Ajilaca/peruri-chipathon-2026/formal/phase08-keccak-stream/README.md

# formal/phase08-keccak-stream/

- Folder ini: sponge dua ronde (`keccak_sponge_r2_*`), Phase 8a.
- `8b/`: sampler `cbd2_core` dan `sample_ntt_core`, lebar keluaran W1 dan W2 (`*_w2.sby`).
- `8c/`: sequencer dengan sampler, varian STORE dan STREAM; `keccak_sampler_stub.sv` menggantikan sampler.
- `8d/`: varian OVERLAP.

Hasil: [../../evidence/phase08/](../../evidence/phase08/README.md).
