Ajilaca/peruri-chipathon-2026/docs/README.md

# docs/

Dokumentasi proyek. Kode ada di `rtl/`, bukti mentah di [`../evidence/`](../evidence/README.md).

| Item | Isi |
|---|---|
| [ROADMAP.md](ROADMAP.md) | fase, kriteria selesai, matriks ablasi (satu baris per konfigurasi, angka dari bukti) |
| [decisions/](decisions/README.md) | ADR, ringkasan keputusan aktif, daftar pilihan terbuka |
| [results/](results/README.md) | satu file hasil per fase (`phaseNN.md`), dasar persetujuan fase |
| [evidence/](evidence/README.md) | indeks bukti per fase (isinya ada di `../evidence/`) |
| [reports/](reports/README.md) | laporan PDF per fase dan laporan lengkap |

Urutan baca : README root, ROADMAP, `decisions/decision_summary.md`, `results/phase9m.md`.
