Ajilaca/peruri-chipathon-2026/evidence/phase09/9c/regression_phase8.md

# Regresi Fase 8 pada Fase 9 (CRG-5), 2026-10-04

MEASURED: skrip verifikasi Fase 8 dijalankan ulang pada working tree yang memuat Fase 9 (file Fase 6-8 yang dibekukan tidak diubah; lihat `verify.md`), `scripts/test/phase8cd_verify.sh` lalu `KS_OUTW=2 scripts/test/phase8b_verify.sh` (yang menjalankan ulang `scripts/test/phase8a_verify.sh`). Hanya header bagian dan baris hasil dari log mentah yang disimpan di sini (log mentah sekitar 1 MB; alur lengkap `scripts/phase8*_verify.sh`). Hanya simulasi, lint, dan formal.

## scripts/test/phase8cd_verify.sh
```
## V2 golden model (STORE, STREAM, OVERLAP, STRESS) against the unmodified golden K-PKE, hazard checker
rc=0
## V2 ROM regenerated byte for byte
rc=0
## V1 verilator --lint-only -Wall kpke_smp_top_s10 (VAR=0 STREAM_A=0 OVERLAP=0 NPOLY=24)
rc=0
## V1 slang kpke_smp_top_s10 (VAR=0 STREAM_A=0 OVERLAP=0 NPOLY=24)
rc=0
## V1 verilator --lint-only -Wall kpke_smp_top_s10 (VAR=1 STREAM_A=1 OVERLAP=0 NPOLY=12)
rc=0
## V1 slang kpke_smp_top_s10 (VAR=1 STREAM_A=1 OVERLAP=0 NPOLY=12)
rc=0
## V1 verilator --lint-only -Wall kpke_smp_top_s10 (VAR=2 STREAM_A=1 OVERLAP=1 NPOLY=12)
rc=0
## V1 slang kpke_smp_top_s10 (VAR=2 STREAM_A=1 OVERLAP=1 NPOLY=12)
rc=0
## V1 verilator --lint-only -Wall kpke_smp_top_s10 (VAR=3 STREAM_A=1 OVERLAP=1 NPOLY=12)
rc=0
## V1 slang kpke_smp_top_s10 (VAR=3 STREAM_A=1 OVERLAP=1 NPOLY=12)
rc=0
## V3-V6 verilator VAR=0
[verilator] TOTAL: 6/6 passed
rc=0
## V3-V6 icarus VAR=0
[icarus] TOTAL: 6/6 passed
rc=0
## V3-V6 verilator VAR=1
[verilator] TOTAL: 8/8 passed
rc=0
## V3-V6 icarus VAR=1
[icarus] TOTAL: 8/8 passed
rc=0
## V3-V6 verilator VAR=2
[verilator] TOTAL: 9/9 passed
rc=0
## V3-V6 icarus VAR=2
[icarus] TOTAL: 9/9 passed
rc=0
## V3-V6 verilator VAR=3
[verilator] TOTAL: 9/9 passed
rc=0
## V3-V6 icarus VAR=3
[icarus] TOTAL: 9/9 passed
rc=0
## V7 formal 8c: formal/run/run_formal_phase8c.py
rc=0
## V7 formal 8d: formal/run/run_formal_phase8d.py
rc=0
## V8 Phase 6 files unmodified since their commit (git diff against the Phase 7 base 6874609)
OVERALL: PASS
```

## KS_OUTW=2 scripts/test/phase8b_verify.sh
```
## V10 regression: scripts/test/phase8a_verify.sh (K0 and C5)
[verilator] TOTAL: 9/9 passed
[icarus] TOTAL: 9/9 passed
OVERALL: PASS
[verilator] TOTAL: 9/9 passed
[icarus] TOTAL: 9/9 passed
OVERALL: PASS
rc=0
## V10 regression: formal/run/run_formal_phase7.py
rc=0
## V10 regression: formal/run/run_formal_phase8a.py
rc=0
## V1 verilator --lint-only -Wall sample_ntt_core (OUTW = 2)
rc=0
## V1 verilator --lint-only -Wall cbd2_core (OUTW = 2)
rc=0
## V1 verilator --lint-only -Wall keccak_sampler (CORE_R2 = 1, OUTW = 2)
rc=0
## V1 verilator --lint-only -Wall keccak_sampler (CORE_R2 = 0, OUTW = 2)
rc=0
## V1 slang keccak_sampler (OUTW = 2)
rc=0
## V2 golden sampler model against the unmodified golden primitives
rc=0
## V3-V8 verilator (OUTW = 2)
[verilator] TOTAL: 34/34 passed
rc=0
## V3-V8 icarus (OUTW = 2)
[icarus] TOTAL: 34/34 passed
rc=0
## V10 rerun of the W1 test set against the current RTL (OUTW = 1) verilator
[verilator] TOTAL: 31/31 passed
rc=0
## V10 rerun of the W1 test set against the current RTL (OUTW = 1) icarus
[icarus] TOTAL: 31/31 passed
rc=0
## V9 formal: formal/run/run_formal_phase8b.py (W1 and W2 rows)
rc=0
OVERALL: PASS
```

## Parameter terkunci (check_params.py)
```
ok        Q         = 3329
ok        N         = 256
ok        ZETA      = 17
ok        K         = 3
ok        ETA1      = 2
ok        ETA2      = 2
ok        DU        = 10
ok        DV        = 4
ok        EK_BYTES  = 1184
ok        DK_BYTES  = 2400
ok        CT_BYTES  = 1088
ok        SS_BYTES  = 32

check_params: all locked parameters match.
```
