Ajilaca/peruri-chipathon-2026/evidence/phase08/8b/quartus_SM1-K0.md

# MEASURED - Hasil Quartus untuk revisi `SM1-K0`

- Dibuat: 2026-10-03 08:03 UTC oleh `extract_quartus_report.py` (nilai disalin dari laporan, tidak dihitung)
- Direktori sumber: `quartus/phase08b_sampler/output_files_SM1-K0`
- Catatan: Fase 8b tahap W1: keccak_sampler (SampleNTT dan CBD2 streaming, satu koefisien per siklus), revisi SM1-K0, kernel-only dengan virtual pin; RTL rtl/sample pada working tree di atas commit dcae678 (di-commit sesudahnya)

## Fitter (`SM1-K0.fit.summary`)

| Item | Nilai (verbatim) |
|---|---|
| Fitter Status | Successful - Sat Oct  3 15:01:58 2026 |
| Quartus Prime Version | 25.1std.0 Build 1129 10/21/2025 SC Lite Edition |
| Revision Name | SM1-K0 |
| Top-level Entity Name | keccak_sampler |
| Family | Cyclone V |
| Device | 5CSEBA6U23I7 |
| Timing Models | Final |
| Logic utilization (in ALMs) | 3,470 / 41,910 ( 8 % ) |
| Total registers | 1914 |
| Total pins | 0 / 314 ( 0 % ) |
| Total block memory bits | 0 / 5,662,720 ( 0 % ) |
| Total RAM Blocks | 0 / 553 ( 0 % ) |
| Total DSP Blocks | 0 / 112 ( 0 % ) |
| Total PLLs | 0 / 6 ( 0 % ) |
| Total DLLs | 0 / 4 ( 0 % ) |

Penyebut di atas adalah penyebut fitter sendiri; kutip persis seperti tercetak.

## Timing (`SM1-K0.sta.summary`)

| Tipe | Slack (ns) | TNS |
|---|---|---|
| Slow 1100mV 100C Model Setup 'clk_i' | 23.928 | 0.000 |
| Slow 1100mV 100C Model Hold 'clk_i' | 0.414 | 0.000 |
| Slow 1100mV 100C Model Minimum Pulse Width 'clk_i' | 19.243 | 0.000 |
| Slow 1100mV -40C Model Setup 'clk_i' | 24.496 | 0.000 |
| Slow 1100mV -40C Model Hold 'clk_i' | 0.438 | 0.000 |
| Slow 1100mV -40C Model Minimum Pulse Width 'clk_i' | 19.136 | 0.000 |
| Fast 1100mV 100C Model Setup 'clk_i' | 30.287 | 0.000 |
| Fast 1100mV 100C Model Hold 'clk_i' | 0.176 | 0.000 |
| Fast 1100mV 100C Model Minimum Pulse Width 'clk_i' | 19.562 | 0.000 |
| Fast 1100mV -40C Model Setup 'clk_i' | 32.052 | 0.000 |
| Fast 1100mV -40C Model Hold 'clk_i' | 0.162 | 0.000 |
| Fast 1100mV -40C Model Minimum Pulse Width 'clk_i' | 19.553 | 0.000 |

- Slack setup terburuk: **23.928 ns** (Slow 1100mV 100C Model Setup 'clk_i')
- Slack hold terburuk: **0.162 ns** (Fast 1100mV -40C Model Hold 'clk_i')

## Fmax (`SM1-K0.sta.rpt`, panel Fmax Summary)

| Model | Fmax | Fmax terbatas | Nama clock | Catatan |
|---|---|---|---|---|
| Slow 1100mV 100C Model Fmax Summary | 62.22 MHz | 62.22 MHz | clk_i |  |
| Slow 1100mV -40C Model Fmax Summary | 64.5 MHz | 64.5 MHz | clk_i |  |

## Jumlah pesan log kompilasi

- Peringatan kritis: 1
- Peringatan: 7
- Kesalahan: 0

Peringatan kritis harus dibahas secara tertulis.
