Ajilaca/peruri-chipathon-2026/docs/results/README.md

# Artefak hasil per fase

Satu file per fase yang selesai: `phase<NN>.md` (NN mengikuti `docs/ROADMAP.md`; `phase05m` dan `phase9m` untuk sub-fase).
Ini satu halaman yang dibaca peninjau untuk memutuskan "apakah fase ini benar-benar selesai?".

- Hanya fakta, dari file di repository ini. `PASS` memerlukan bukti yang ada.
- Semua baris kriteria harus punya bukti yang ada sebelum meminta persetujuan.
- Fase yang jujur berstatus `PARTIAL` boleh; `DONE` dengan bukti yang hilang tidak boleh.
