Ajilaca/peruri-chipathon-2026/evidence/phase05m/test_plan_s7.md

<!-- claim-lint: skip-file (internal test plan, not proposal text) -->
# Fase 5M, langkah S7: pecah jalur baca memori (P = 6 -> 7) - test plan dan aturan adopsi

Ditulis 2026-10-02, sebelum RTL S7 apa pun dan sebelum pengukuran S7 apa pun (CRG-4). Lingkup dan aturan: ADR 0017, ADR 0019 (catatan amandemen 2: S7 dan S8
direncanakan sebelum Fase 7), ADR 0020 (M6 adalah basis). Konfigurasi basis: M6 (`rtl/ntt/ntt_core_m6_p6.sv`: Barrett, INTT tanpa pass skala,
P = 6, NTT = INTT = 119 siklus; median Fmax MEASURED seed 1-6 34.430 MHz, ALM 9,394-9,441, 16 DSP,
`evidence/phase05m/s6/selection_worksheet.md`). Label: MEASURED, INFERENCE, ESTIMATE, NOT MEASURED.

## 1. Perubahannya (satu perubahan)
Jalur kritis C4b-B / M6 dimulai di stage baca `rtl/mem/poly_mem_multiport_pipe.sv`: register kendali (bank, offset, slot, setelah potongan M) ->
pemilih alamat baca per bank di antara 16 port -> baca penyimpanan (32 word per bank, flip-flop) -> pemilih keluaran (bank, sub-port) di antara 16 port baca ->
`sub_mod` -> pengali. MEASURED (baseline C3-P6, memori yang sama): dekode alamat baca dan mux baca 21.292 ns dari 29.345 ns
(`evidence/phase05/baseline/c3p6_critical_path.md`); untuk C4b-B 21.03 ns + `sub_mod` 4.22 ns + DSP 3.59 ns
(`evidence/phase05/5c/precheck_critical_path.md`). S7 menaruh satu stage register di tengah bacaan itu:
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
