Ajilaca/peruri-chipathon-2026/evidence/phase05m/test_plan_s8.md

<!-- claim-lint: skip-file (internal test plan, not proposal text) -->
# Fase 5M, langkah S8: register jalur tulis dan satu gelembung per arah (P = 7 -> 8) - test plan dan aturan adopsi

Ditulis 2026-10-02, setelah RTL S8 ditulis dan di-lint (Verilator `-Wall`, slang: 0 peringatan) tetapi sebelum simulasi S8 apa pun dan sebelum kompilasi Quartus
S8 apa pun (CRG-4: tidak ada di bawah yang bergantung pada pengukuran S8). Lingkup dan aturan: ADR 0017 (S8 = tuas 4 paket keputusan: P -> 8, satu stall tak bergantung data
per transformasi), ADR 0019 (catatan amandemen 2: S7 dan S8 direncanakan sebelum Fase 7), ADR 0020, Amandemen A1 `test_plan.md` (regresi penuh Fase 0-5 dijalankan
sekali, di S8, pada pohon akhir). Konfigurasi basis: S7 (`rtl/ntt/ntt_core_s7_p7.sv`, revisi S7, seed 1-6 di `s7/`). Basis S8 adalah S7 apa pun hasil
aturannya: S8 didefinisikan sebagai tuas 4 di atas baca terpecah (tabel ADR 0017); ini mengikuti instruksi tim 2026-10-02 (chat: "kerjakan sesuai
dengan agenda hari ini ... S7-S8 selesai"). Hasil aturan S7 tetap tercatat tanpa perubahan. Label: MEASURED, INFERENCE, ESTIMATE, NOT MEASURED.
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
