Ajilaca/peruri-chipathon-2026/(commit log)

2026-09-28 docs(fase0): temuan errata FIPS 203 dan ADR 0003 (Proposed)
    - docs/evidence/golden/fips203_errata_2026-09-28.md: sha256 PDF FIPS 203 + spreadsheet
    errata, 2 butir errata dikutip dan dianalisis dampaknya (keduanya non-normatif, tidak
    memengaruhi golden model), cross-check parameter Tabel 2/3 ML-KEM-768 (cocok persis
    dengan rencana k=3 eta1=2 eta2=2 du=10 dv=4)
    - docs/decisions/0003-...: ADR Proposed merekam temuan di atas, menunggu penerimaan tim
    - docs/decisions/PENDING.md #9: diperbarui, ditutup setelah ADR diterima tim
2026-09-28 tb/golden: bukti bit-exact vs 80 vektor ACVP resmi ML-KEM-768 (80/80 lulus)
    - fetch_acvp_vectors.py: unduh 2 internalProjection.json dari commit ACVP-Server terpatok
    975de31eb83d87039ec88934fdc47d8c312b892d, verifikasi sha256 terhadap kat_sources.md sebelum
    disimpan (JSON tidak di-commit, tb/vectors/acvp/*.json di .gitignore)
    - run_kat.py: banding model kita vs grup ML-KEM-768 saja (keyGen, encapsulation, decapsulation
    termasuk 'modified ciphertext', encapsulationKeyCheck, decapsulationKeyCheck), hex
    case-insensitive
    - docs/evidence/golden/kat_mlkem768_2026-09-28.txt: log mentah, 80/80 lulus, 0 tcId gagal.
    Catatan: file keyGen ACVP ternyata isSample=false (bukan true seperti asumsi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
2026-09-28 tb/golden: cross-check independen vs kyber-py 1.2.0, N=2000 (2000/2000 cocok)
    - crosscheck_kyberpy.py: bandingkan keygen_internal/encaps_internal/decaps_internal
    (ciphertext asli dan yang di-flip 1 bit) terhadap kyber-py, oracle terpasang di venv
    throwaway di luar repo (~/.cache/chip2026-oracle), seed RNG tetap (20260928), tidak masuk
    requirements-dev.txt maupun disalin ke repo
    - docs/evidence/golden/crosscheck_kyberpy_2026-09-28.txt: log mentah, 2000/2000 trial cocok
    di semua tahap, 0 selisih
2026-09-29 docs(fase1): test plan Fase 1 (CRG-4) sebelum RTL/tes ditulis
    Kriteria selesai, corner case, dan jumlah tes untuk modmul_reduce, base_case_multiply,
    butterfly, dan ntt_core didaftar dulu sebelum implementasi.
2026-09-29 tb(fase1): cocotb bit-exact vs golden model, 10/10 lulus di Icarus dan Verilator
    - test_modmul.py, test_base_case_multiply.py, test_butterfly.py: unit-level vs tb/golden
    - test_ntt_core.py: NTT/INTT bit-exact (5 corner + 100 acak per arah), roundtrip 50 acak,
    cek siklus konstan (CRG-7)
    - run_ntt_tests.py: runner per simulator, pola sama dengan scripts/smoke/sim/run_smoke.py
    - conftest.py: wiring sys.path ke tb/golden
    Catatan debug (bukan bug RTL): versi awal _run() memberi pulsa start_i satu siklus yang race
    dengan waktu visibilitas tulis cocotb/VPI; diperbaiki dengan menahan start_i sampai busy_o naik,
    bukan mengubah RTL.
2026-09-29 formal(fase1): bukti keamanan FSM ntt_core via SymbiYosys k-induction (CRG-8)
    - ntt_core_props.sv: busy_o turun -> done_o pasti 1 SATU siklus kemudian (dicocokkan dengan
    timing RTL yang sebenarnya, bukan asumsi keliru pertama yang ditangkap oleh langkah induksi)
    - ntt_core_formal_top.sv: pembungkus top-level (bukan `bind`, parser Yosys oss-cad-suite tidak
    menerima sintaks bind yang dicoba)
    - ntt_core_safety.sby: mode prove, depth 6, lulus basecase + induction
    Liveness (FSM pasti sampai done_o) TIDAK dibuktikan formal di sini -- BMC sedalam ~900-1150 siklus
    tidak praktis untuk fase ini; bukti liveness datang dari regresi cocotb, bukan SymbiYosys.
2026-09-29 docs(fase1): log evidence regresi cocotb dan bukti formal
    - cocotb_regression_2026-09-29.txt: 10/10 lulus di kedua simulator, siklus NTT=897 INTT=1153
    konstan di semua corner case + acak
    - formal_ntt_core_safety_2026-09-29.txt: log SymbiYosys lengkap (k-induction PASS)
2026-09-29 docs(fase1): result_phase1.md (PARTIAL) + perbarui status ROADMAP
    Status PARTIAL jujur: semua CRG simulasi/lint/formal lulus (CRG-1,2,3,4,5,6,7,8,10), tapi CRG-9
    (bukti Quartus) dan ADR target-clock belum ada -- Quartus tidak tersedia di sesi ini. Tidak ada
    angka ALM/register/M10K/DSP/Fmax yang diklaim di mana pun. check_result.py dan claim_lint.py
    0 error.
2026-09-29 docs: panduan compile Quartus manual untuk Fase 1 config C0
    Langkah GUI Quartus Prime Lite (qpf/qsf/sdc siap pakai, virtual pin, clock provisional 50 MHz
    sampai ADR resmi), cara ekstrak bukti MEASURED lewat quartus-report, dan checklist hal yang
    sering salah. Ditulis untuk dipakai manual oleh tim di mesin dengan Quartus terpasang (tidak
    tersedia di sandbox sesi Claude Code).
2026-09-29 quartus(fase1): proyek C0 -- ntt_core, virtual pin, clock provisional 20.000 ns
    - phase01_ntt_c0.qpf, C0.qsf: top ntt_core, Cyclone V 5CSEBA6U23I7, semua port virtual pin
    (kompilasi kernel-only, belum ada board)
    - C0.sdc: create_clock 20.000 ns pada clk_i (PROVISIONAL, belum ADR tim) + false path rst_ni
    - report_critical_paths.tcl: drill-down quartus_sta READ-ONLY di netlist post-fit yang sudah
    ada (tanpa recompile, RTL/QSF/SDC tidak diubah) -- laporan C0.sta.rpt bawaan cuma ringkasan,
    tidak ada detail jalur
    - segment_path.py, extract_c0_timing_evidence.py: ubah laporan Quartus jadi bukti MEASURED,
    tidak ada angka yang diketik manual
2026-09-29 docs(fase1): bukti MEASURED Quartus C0 -- timing GAGAL, 7010 ALM, Fmax 14.64 MHz
    - docs/evidence/quartus/C0-20260929.md: ekstrak fit.summary/sta.summary standar
    - docs/evidence/phase01-ntt-baseline/quartus_C0_timing_analysis_2026-09-29.md(+.json):
    status tiap tahap, semua corner, jalur terburuk (layer_q[2] -> poly_mem, delay 67.684 ns),
    atribusi delay per struktur (pembagi modulo 'lpm_divide' 57.5% dari jalur terburuk),
    klasifikasi 3104 endpoint, dan bukti metodologi clock/virtual-pin
    Worst setup slack -48.323 ns @ 20.000 ns (provisional) -- timing TIDAK terpenuhi di 4 corner.
    Tidak ada angka yang diketik manual; semua diturunkan skrip dari laporan Quartus asli.
2026-09-29 tb(fase2): cocotb bit-exact + siklus identik C0, 12/12 di Icarus dan Verilator
    - test_bank_map.py: eksaustif 256/256 alamat vs tb/mem/bank_model.py, utk L=1,2,4,8
    - test_ntt_core_c1.py: bit-exact vs tb/golden/primitives.py + cek siklus SAMA PERSIS
    dengan C0 (NTT=897, INTT=1153) -- bukan cuma 'konstan', tapi sama dengan Fase 1 (stall=0)
    - run_mem_tests.py: runner per simulator, pola sama seperti tb/ntt/run_ntt_tests.py
2026-09-29 quartus(fase2): proyek C1 -- ntt_core_c1, sama persis metodologi C0
    C1.qsf/qpf/sdc: top ntt_core_c1, virtual pin, clock provisional 20.000 ns (SAMA dengan C0.sdc,
    supaya perbandingan apple-to-apple). report_worst_path.tcl: drill-down read-only jalur
    terburuk pada netlist post-fit yang sudah ada.
2026-09-29 docs(fase2): result_phase2.md (PARTIAL) + ROADMAP C1 terisi
    - result_phase2.md: 5/5 kriteria PASS milik Fase 2 sendiri terpenuhi (bebas-tabrakan, stall=0,
    bit-exact, siklus konstan, baris C1 terisi), tapi CRG-9 tetap FAIL (timing) dan status
    keseluruhan PARTIAL. Dicatat jujur: fase ini dimulai sebelum kotak Approval Fase 1 dicentang,
    atas instruksi langsung tim -- bukan karena gerbang terpenuhi.
    - ROADMAP.md: status line + baris C1 ablation matrix diisi dari bukti.
2026-09-29 docs(fase3): ADR 0004 -- kriteria pemilihan L (siklus-min dalam budget ALM 25%)
    Primer: minimalkan jumlah siklus, dibatasi budget ALM 25% dari device
    target (10.478 ALM). Sekunder: evaluasi AT informasional setelah ada
    clock valid timing-nya, tidak otomatis override pilihan primer.
    Diputuskan Faza Dzil, Tim J5, sebelum sweep Quartus C2-L1..L8 diukur.
    Menutup PENDING #14.
2026-09-30 exp(fase3): K2 -- lebar t_q minimal pada C2 (valid tapi tidak cukup untuk L=8)
    Eksperimen suplementer Fase 3 atas C2, baseline dibekukan: ntt_core_c2_k2.sv
    = ntt_core_c2.sv dengan t_q selebar $clog2(128/NUM_LANES) bit (4 bit di L=8)
    alih-alih 8 bit. ntt_core_c2.sv dan semua evidence C2-L1..L8 tidak diubah.
    - Benar secara fungsional dan cycle-identical: cocotb 16/16 di Verilator dan
    Icarus, semua L; L=8 tetap NTT=113, INTT=369, 8 butterfly/siklus.
    - ALM L=8 membaik 11.446 -> 11.232 (-214), MEASURED
    (docs/evidence/quartus/C2-L8-K2-20260930.md).
    - L=8 tetap di atas budget ADR 0004 (10.478 ALM) sebesar 754 ALM.
    - Timing tetap gagal (slack setup terburuk -107,314 ns @ 20 ns, Fmax 7,85 MHz).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
2026-09-30 exp(fase3): K1 -- satu pengali per butterfly (C2-K2-K1), L=8 kembali di bawah budget ALM
    Eksperimen suplementer yang disetujui tim (mengubah datapath butterfly, di luar
    lingkup tertulis Fase 3), di atas K2, diukur untuk L=1/2/4/8. butterfly_shared.sv:
    persamaan identik dengan butterfly.sv tapi satu modmul_reduce dipakai bergantian
    per mode; modmul_reduce.sv dan semua baseline tidak diubah. K2 kini juga terukur
    untuk L=1/2/4.
    - Bit-exact: unit butterfly_shared 2/2 dan core 16/16 di Verilator dan Icarus;
    siklus identik dengan C2 (L=8: NTT=113, INTT=369, 8 butterfly/siklus).
    - ALM MEASURED C2 -> C2-K2-K1: L1 6018->5566, L2 5728->5374, L4 7629->6775,
    L8 11446->9754 (724 di bawah budget 10.4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
2026-09-30 exp(fase3): K1 -- ekuivalensi butterfly vs butterfly_shared terbukti dua cara
    Menutup item terbuka K1. (1) Formal: modmul_reduce diabstraksi sebagai fungsi
    tak-terinterpretasi dengan batasan konsistensi (fungsi murni), lalu logika
    operand/tambah/kurang/mux di sekitarnya dibuktikan ekuivalen untuk semua mode
    dan semua a,b,zeta < q: PASS; dua kontrol negatif (operand inverse sengaja
    salah; tanpa asumsi konsistensi) FAIL sesuai harapan. (2) Simulasi exhaustive
    Verilator pada RTL asli, tiga arah terhadap golden, 2 x 3329^3 =
    73.785.560.578 kombinasi, 0 mismatch, tanpa asumsi (1.229 detik, 8 proses).
    Bukti formal aritmetika penuh tetap timeout 30 menit dan dicatat sebagai
    catatan, bukan hasil. Ca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
    [k1_butterfly_equiv_abs.sv, k1_butterfly_equiv_abs_noack.sv, k1_negctl_butterfly_shared_wrong_operand.sv, modmul_reduce_uf.sv]
2026-09-30 formal(fase3): alur formal diperbaiki -- celah L>1 ternyata artefak harness, kini PASS
    Akar masalah UNKNOWN pada NUM_LANES>1: proc_rom Yosys mengubah tabel case
    256-entri bank_map_rom (dan twiddle_rom) menjadi sel $mem; pada langkah
    induksi isinya menjadi state bebas sehingga solver "menemukan" overflow pada
    ROM yang isinya bukan tabel sebenarnya (state tidak reachable). Bukan masalah
    RTL, reset, atau assertion. Perbaikan hanya di harness: memory_map -rom-only
    (ROM = konstanta, fakta desain) + frontend read_slang (read -formal bawaan
    membiarkan add_mod/sub_mod tanpa driver) + asumsi reset yang ekuivalen.
    RTL tidak diubah.
    Hasil formal/run_formal_slang.py: 19/19 sesuai ekspektasi.
    - C2, C2-K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
    [ntt_core_c2_formal_top.sv, ntt_core_c2_k2_formal_top.sv, ntt_core_c2_k2_k1_formal_top.sv]
2026-09-30 docs(fase3): koreksi catatan formal -- CRG-8 kini PASS, penjelasan lama diralat
    result_phase3.md: CRG-8 FAIL -> PASS untuk L=1/2/4/8 (bank_overflow_o==0,
    handshake busy/done, rentang t_q/layer_q; bukan bit-exactness), merujuk
    formal_rerun_2026-09-30.md. Penjelasan 2026-09-29 di Bagian 6 dipertahankan
    sebagai catatan tetapi ditandai digantikan dan diralat: penyebabnya bukan
    salah baca tabel case oleh frontend, melainkan ROM yang menjadi state bebas
    di langkah induksi (artefak harness). ROADMAP (baris status), catatan K1
    (caveat 4) dan ADR 0005 (open items) disesuaikan. Status fase tetap PARTIAL
    (CRG-9 timing); kotak Approval tidak disentuh.
2026-09-30 docs(laporan): laporan Fase 3 diperbarui -- K2/K1, L=8 terpilih, ralat formal
    Laporan PDF Fase 3 (Bahasa Indonesia) ditulis ulang sesuai keadaan 2026-09-30:
    hasil C2 sebagai pembanding, audit ALM L=8, eksperimen K2 dan K1 (C2-K2-K1),
    ekuivalensi butterfly, hasil formal 19/19 beserta cakupannya, ralat atas
    kesimpulan formal di versi 2026-09-29, dan keputusan ADR 0005 (C2-K2-K1, L=8).
    Status tetap PARTIAL; Approval belum dicentang. Semua angka dari berkas
    evidence di repo.
2026-10-01 docs(fase4): seed sweep P=4/P=6 (seed 1-6) sebagai masukan ADR 0008; bukti di docs/evidence/phase04-pipeline/seed_sweep_2026-10-01.md
2026-10-01 docs(fase5): ADR 0015 Proposed, 5d tidak dicoba di Fase 5
2026-10-02 docs(fase5m): amandemen A1, regresi penuh (V9) sekali di S8; catatan di ADR 0017
2026-10-02 rtl(fase6): sequencer K-PKE (KeyGen/Encrypt/Decrypt), poly_store, pwm_unit, ROM gamma dan program dari golden, tes cocotb, formal, revisi Quartus P6
2026-10-02 docs(fase6): analisis jalur kritis S7/S8 (pembatas: arbitrasi slot), test plan dan aturan adopsi S10 sebelum RTL
2026-10-02 docs(fase6): S10 diadopsi oleh aturan (median Fmax 44.320 MHz, 5.077 ALM, 20 ns terpenuhi 6/6 seed), ADR 0025 Proposed, S7 di 20 ns (0/6), P6 Quartus, result_phase6.md, ROADMAP, PENDING 28
2026-10-03 docs(fase6): rincian sumber daya S10 vs S7 per entitas (penghematan seluruhnya di memori), koreksi estimasi crossbar S9
2026-10-03 docs(fase7): laporan PDF Fase 7 (build_phase7_report.py), terdaftar di result_phase7.md
2026-10-03 docs(fase8b): test plan, gate dan aturan pemilihan sampler streaming (lebar keluaran 1 lalu 2 koefisien per siklus), golden sampler_model.py, sebelum RTL dan sebelum pengukuran
2026-10-03 rtl(fase8b): sampler streaming W1 (SampleNTT dan CBD2, 1 koefisien per siklus) di atas sponge C5/K0, tes cocotb (2 simulator), formal S1-S5, revisi Quartus SM1 seed 1-6; gate lulus (median Fmax 51,22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
2026-10-03 rtl(fase8b): sampler streaming W2 (2 koefisien per siklus, parameter OUTW), tes cocotb (2 simulator) dan formal S1-S6 untuk W1 dan W2, revisi Quartus SM2 seed 1-6; gate lulus dan aturan memilih W2 (m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
2026-10-03 docs(fase8c,fase8d): test plan, aturan adopsi dan amandemen A1 untuk 8c (matriks A di-stream) dan 8d (overlap sampler dan aritmetika); golden kpke_smp_model.py dengan program STORE, STREAM, OVERLAP, 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
2026-10-03 rtl(fase8c,fase8d): sequencer kpke_sched_smp (sampler di dalam, PWMS, SMPN/SMPA, overlap non-blocking dan arbitrasi port tulis), top dengan inti S10, tes cocotb 2 simulator (STORE, STREAM, OVERLAP, S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
2026-10-03 quartus(fase8c,fase8d): revisi SMP0 (STORE), SMP1 (STREAM) dan SMP2 (OVERLAP), seed 1-6 pada 40 ns dan 20 ns informasi, top kpke_smp_top_s10 dengan inti S10 dan sampler C5 (konfigurasi saja; hasil me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
2026-10-03 docs(keputusan): ADR 0030 Proposed, 8d OVERLAP diadopsi aturan atas STREAM (sampling noise di balik transformasi: KeyGen 6.344 siklus, Encrypt 7.655)
2026-10-03 docs: hapus docs/prompts dan baris rujukannya di ROADMAP
2026-10-04 rtl(fase9b): mlkem_hash (G, H, J di atas sponge C5), mlkem_fo_cmp (perbandingan konstan 1.088 byte) dan mlkem_hash_fo_top
2026-10-04 feat(rtl): jalur byte codec dua byte per siklus (parameter CODEC_W2 di mlkem_core, default 0 = perilaku Fase 9)
2026-10-04 docs(fase9m2): evidence 9M-2, core pada 20 ns terpenuhi di 6 dari 6 seed untuk kedua core (result_9m2.md)
2026-10-04 feat(rtl): mlkem_core2 dengan parameter SMP_C5 (sampler K0 di engine), tes sequencer KP_CORE_R2, formal 9f1
2026-10-04 feat(rtl): mlkem_core4, pemuatan polinomial di belakang mesin K-PKE (RUNS, RUNJ, interlock per slot, pemuat dengan backpressure), ROM3 dan model golden3
2026-10-05 evidence: susun per fase di evidence/ (9M di phase9m/batch1 dan batch2), nama file tanpa tanggal
2026-10-05 rtl, tb, quartus: perbarui rujukan path evidence dan result di komentar dan skrip
2026-10-05 docs: README per fase di evidence/ dan README rtl, tb, formal, quartus, scripts, sw, .claude
2026-10-05 docs: README root menjelaskan sistem dan spesifikasi K4 terhadap kapasitas board
